3351666087/desktop-tutorial/docs/presentation/SmartClassroom_IoT104TC_Demo.pptx

Smart Classroom

Energy-Saving, Safety
& Asset Monitoring System

Local-first classroom control with real sensors, actuators, MQTT operations, dashboard analytics and AI-assisted commands.

Local safety works even when the network is offline.

IOT104TC PROJECT

UNO Edge Node

Sensors, state machine and actuators

ESP32 Gateway

Wi-Fi, MQTT and dashboard bridge

UART + ACK

9+

hardware signals

5

priority modes

1s

telemetry cadence

432m

recorded evidence

## Slide 2

ASSESSMENT FIT

Built around the marking scheme

The demo connects hardware, software, architecture, security/privacy, operations and a practical classroom use-case.

Smart Classroom IoT104TC

02

Application

Energy, comfort and safety in one classroom service.

Architecture

UNO local control. ESP32 MQTT gateway.

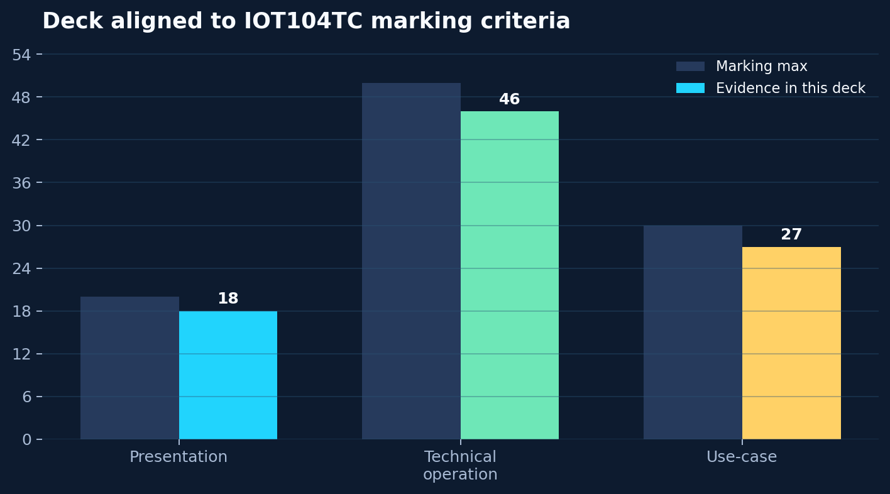
[picture p4: figure]

Evidence

Telemetry, screenshots and self-check.

Security

Fail-safe local control and ignored secrets.

## Slide 3

USE-CASE

A classroom that reacts locally and reports globally

The system behaves like a small building-management service, not a sensor list.

Smart Classroom IoT104TC

03

Sense

Occupancy, light, temperature, gas, flame and emergency button.

01

Decide

Priority state machine: safety first, then comfort and energy saving.

02

Act

Lamp, fan, PWM, tach, buzzer and status light.

03

Operate

MQTT dashboard, manual override, presets, charts and AI timeline.

04

>

>

>

Safety

highest priority

Comfort

adaptive fan/lamp

Ops

ACK + persistence

Data

charts + history

## Slide 4

SYSTEM ARCHITECTURE

Real-time control stays on UNO

Networking adds visibility and commands, but does not become a dependency for safety.

Design decision: ESP32 is a gateway; UNO remains the controller of record.

Smart Classroom IoT104TC

04

Sensors

D2 PIR / A0 Light
A1 Gas / A2 LM35
D8/A3 Flame
D4 Button

Input

Arduino UNO

millis loop
state machine
relay / PWM / tach
buzzer + status light

Edge

ESP32

Serial2 UART
Wi-Fi reconnect
MQTT publish
command bridge

Gateway

Laptop

Mosquitto
web dashboard
history store
AI planner

Service

>

>

>

## Slide 5

Wiring rules

HARDWARE EVIDENCE

Dense hardware, clean responsibility

The build is complex, but each module has a clear role in the service.

Smart Classroom IoT104TC

05

48-kit modules

#18 PIR

#31 TEMT6000

#25 Gas Sensor

#16 Flame Sensor

#5 Active Buzzer

Traffic Light Module

External components

UNO R3
ESP32 Gateway
LM35 powered from ESP32 5V
6-channel relay
12V 4-wire fan
LED + resistor

Common ground is required.
UNO A5 to ESP32 RX2 uses divider.
Relay logic uses RELAY_ON / RELAY_OFF.
No capacitor is added in this build.

ENGINEERING FIX

LM35 became stable after moving power to ESP32 5V and adding ADC guard compensation.

## Slide 6

EDGE INTELLIGENCE

Priority is a state machine

Mixed behavior stays predictable because safety, sensor health, manual control, cooling, lighting and saving are ordered.

Smart Classroom IoT104TC

06

WHY IT MATTERS

Dashboard explains what happened and why.

That turns raw telemetry into an operational classroom service.

SAFETY_ALARM

SENSOR_ERROR

gas/flame/button

invalid sensor state

MANUAL

operator override

COOLING

temperature high

LIGHTING

occupied + dark

ENERGY_SAVING

empty or bright

NORMAL

monitoring

## Slide 7

SAFETY ALARM

The highest-priority path is visible and local

The button gives a safe live demo while gas and flame remain the real sensor paths.

Demo first: press D4, then watch red light, buzzer, fan and dashboard alarm.

Smart Classroom IoT104TC

07

Three inputs

gasDanger
flameDetected
demoEmergency

Trigger

SAFETY ALARM

Overrides lighting, cooling and energy-saving logic immediately.

Decision

Physical response

red light
pulsed buzzer
fan relay ON
PWM = 255

Action

>

>

## Slide 8

Cooling

COMFORT + ENERGY

Human-friendly automation

The classroom avoids waste without making the controls feel abrupt.

Smart Classroom IoT104TC

08

Lighting

Bright room: lamp stays off even if PIR sees motion.
Dark room + occupied: lamp turns on.
No occupancy timeout: lamp turns off.

Temperature threshold starts the relay.
PWM ramps fan intensity.
Tach RPM is interrupt-based and never blocks the system.

10s

occupancy timeout

PWM

smooth fan path

ACK

config confirmed

Local

works offline

## Slide 9

MQTT NETWORK LAYER

Telemetry goes up; commands come back with ACK

The protocol is simple enough to debug and structured enough for a dashboard.

SC2,mode=SAFETY_ALARM,pir=1,temp10=286,gas=520
fan=1,pwm=255,rpm=1320,status=R

ACK loop proves the command actually landed on the UNO.

Smart Classroom IoT104TC

09

Emit

SoftwareSerial line every second

UNO

Parse

Serial2 + Wi-Fi reconnect

ESP32

Publish

JSON plus key topics

MQTT

Operate

Config + presets
manual mode

Web

>

>

>

## Slide 10

DASHBOARD

An operator console, not a raw JSON page

Large cards, live charts, mobile access, manual mode and scene presets make the system usable.

Dashboard screenshots captured from the local running system.

10

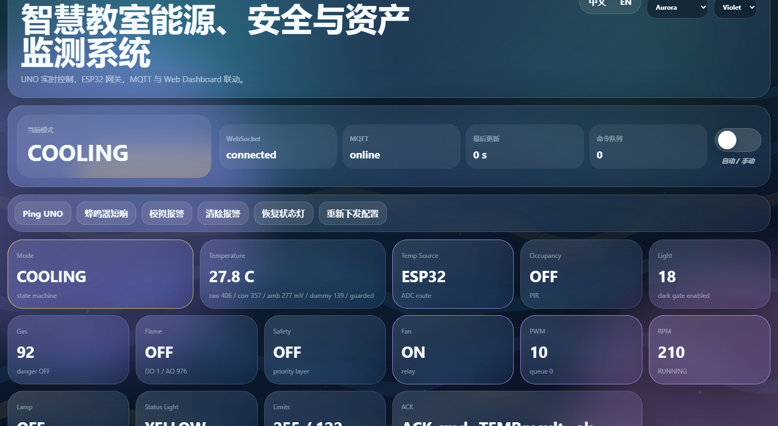
[picture p5: figure]
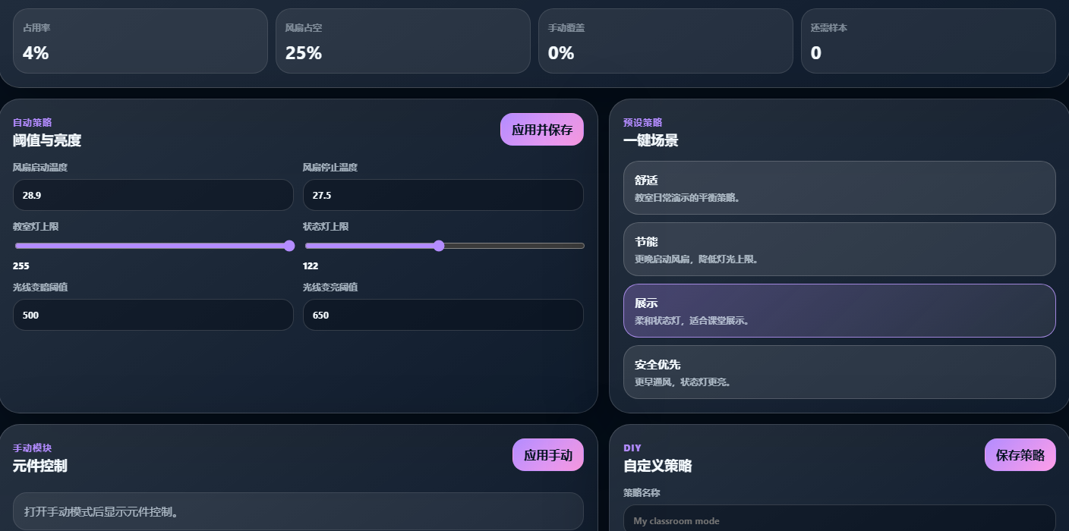
[picture p6: figure]
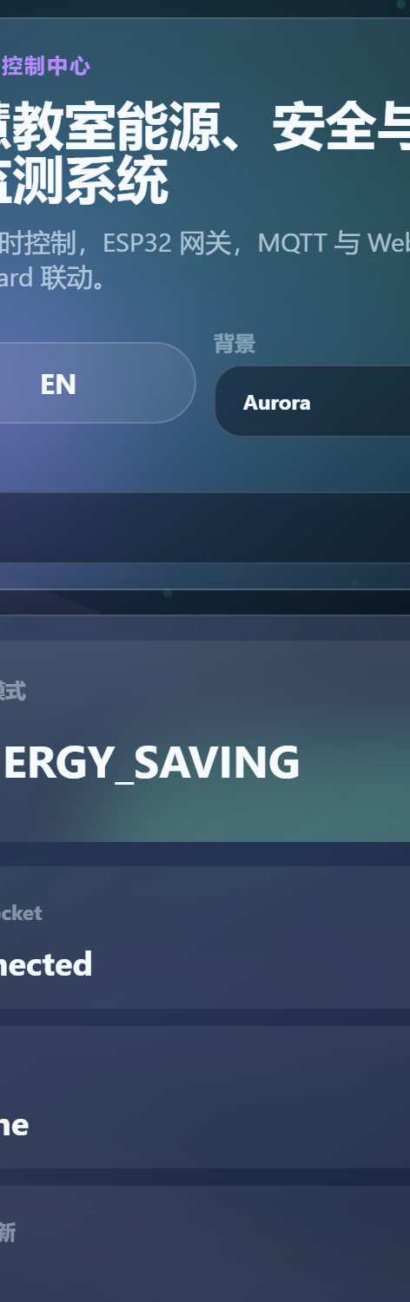
[picture p7: figure]

Auto

manual switch

Scenes

one-click presets

## Slide 11

TELEMETRY EVIDENCE

The demo has history, not just live values

Recorded data supports behavior explanation: modes, temperature response, fan duty and safety events.

9,764 samples | avg temp 28.3C | fan duty 31.5% | safety events 5

Smart Classroom IoT104TC

11

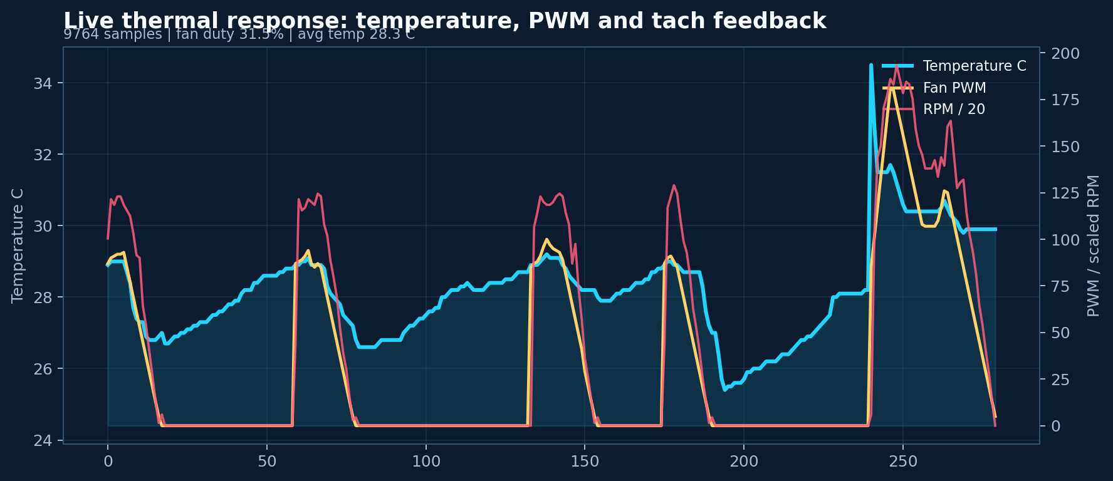
[picture p8: figure]
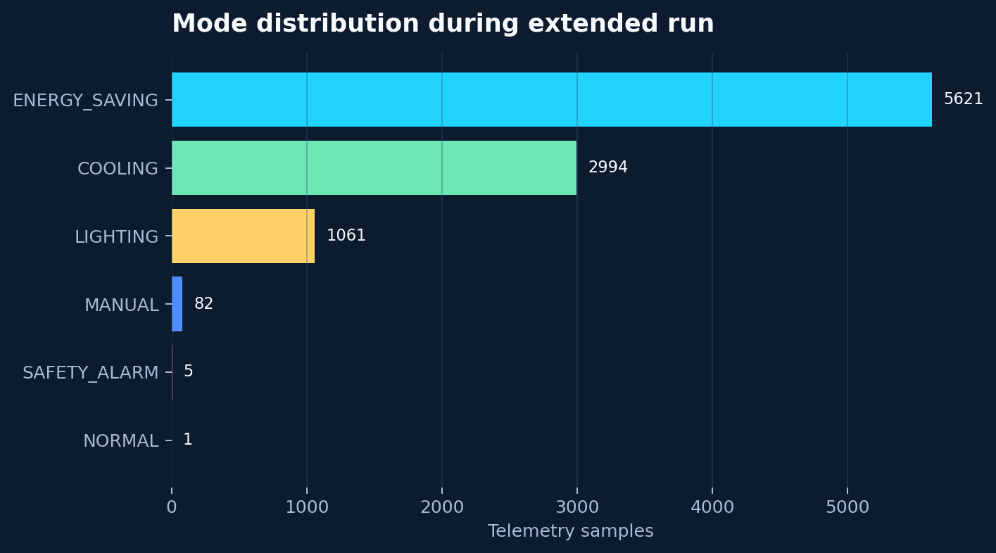
[picture p9: figure]

## Slide 12

MEASURED COMPLEXITY

Complexity comes from closed loops

Sensors, control, gateway, dashboard, persistence and AI all interact with the same physical system.

Smart Classroom IoT104TC

12

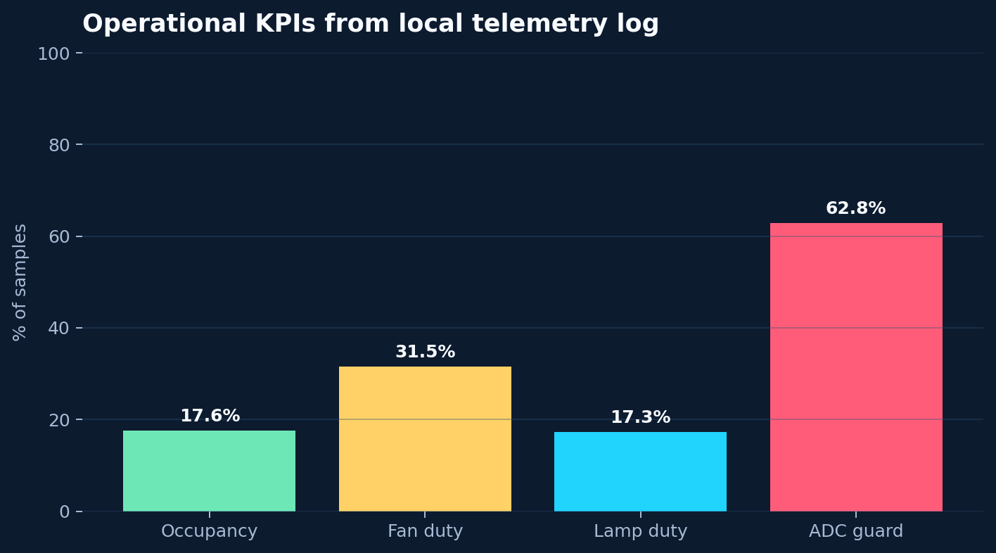
[picture p10: figure]

9,764

telemetry samples

12+

MQTT topics

2-way

UART command + ACK

Local-first

safety path offline

34/34

delivery self-check PASS

## Slide 13

AI OPERATIONS LAYER

Natural language becomes structured control

AI is useful because it turns vague operator intent into ordered tasks and timed actions.

Smart Classroom IoT104TC

13

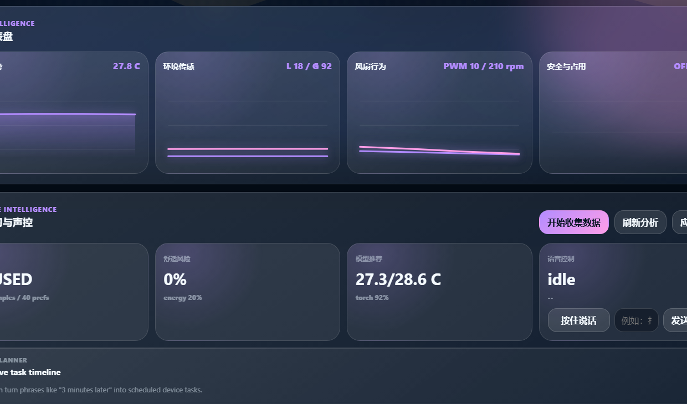
[picture p11: figure]

Voice

Capture

Browser mic input

STT

Text

faster-whisper

Qwen

Plan

structured tasks

>

>

Timeline

Delayed actions auto-clear after completion.

Data

Overrides guide comfort.

## Slide 14

Operations boundary

SECURITY, PRIVACY & OPERATIONS

Demo-friendly, but risk-aware

The project separates safety-critical local control from network convenience and AI assistance.

Production hardening path: authenticated MQTT, TLS, enclosure, fuse, isolation and power filtering.

Smart Classroom IoT104TC

14

Safety boundary

Safety alarm, buzzer, red light and fan response are local on UNO.

Privacy boundary

Microphone is user-triggered and requires browser permission.

MQTT status, ACK logs, persistence and self-check reduce demo risk.

## Slide 15

DEMO CHOREOGRAPHY

Show the strongest engineering first

The audience should see safety and edge control before dashboard polish and AI features.

Do not open with AI. Open with physical safety response.

Smart Classroom IoT104TC

15

Safety

button -> red light -> buzzer -> fan high

P1

Edge

UNO local controller and priority modes

P2

Energy

PIR + light + temp drive lamp and fan

P3

IoT

UART, MQTT topics and ACK command loop

P4

AI

voice, Qwen, timeline and data preference

P5

>

>

>

>

## Slide 16

Self-check gates

REFERENCES + SELF-CHECK

Ready to inspect, rebuild and present

The final package includes sources, assembly materials, scripts and a repeatable delivery check.

Final claim: a local-first IoT classroom controller with safety, energy saving, operations and evidence-backed intelligence.

Smart Classroom IoT104TC final presentation package

16

References

Arduino UNO R3 docs
Espressif Arduino-ESP32 Serial docs
Eclipse Mosquitto config docs
Arduino PubSubClient docs
Texas Instruments LM35 page

PPT structure
required docs
firmware presence
secret scan
Node/Python syntax
UNO + ESP32 compile
