3351666087/desktop-tutorial/docs/SELF_CHECK_REPORT.md

# Smart Classroom Delivery Self-Check

- Generated: 2026-05-27 22:06:02
- Root: `D:\desktop\新项目`
- Summary: PASS 74 / WARN 0 / FAIL 0

| Status | Check | Detail |
| --- | --- | --- |
| PASS | required file: README.md | 12,310 bytes |
| PASS | required file: docs/presentation/SmartClassroom_IoT104TC_Demo.pptx | 2,267,528 bytes |
| PASS | required file: docs/presentation/SmartClassroom_IoT104TC_Demo.pdf | 790,604 bytes |
| PASS | required file: docs/FOUR_PERSON_PRESENTATION_PLAN_ZH.md | 9,574 bytes |
| PASS | required file: docs/SmartClassroom_4Person_Presentation_Plan_ZH.pdf | 335,820 bytes |
| PASS | required file: docs/SmartClassroom_Team_Guide_ZH.pdf | 485,673 bytes |
| PASS | required file: dist/SmartClassroom_Team_Delivery_Pack.zip | 3,857,106 bytes |
| PASS | required file: docs/SmartClassroom_Port_Connection_Check_ZH.pdf | 298,305 bytes |
| PASS | required file: docs/SmartClassroom_Feature_Logic_Guide_ZH.pdf | 451,359 bytes |
| PASS | required file: docs/TEAM_FEATURE_GUIDE_ZH.md | 14,121 bytes |
| PASS | required file: docs/SmartClassroom_Assembly_Checklist_ZH.pdf | 298,305 bytes |
| PASS | required file: docs/SmartClassroom_Environment_Setup_ZH.pdf | 303,858 bytes |
| PASS | required file: docs/SmartClassroom_Speech_Script_Bilingual.pdf | 275,491 bytes |
| PASS | required file: docs/SmartClassroom_Onsite_Assembly_Checklist.pdf | 680,525 bytes |
| PASS | required file: docs/ASSEMBLY_CHECKLIST.md | 6,845 bytes |
| PASS | required file: docs/ENV_SETUP_ZH.md | 6,601 bytes |
| PASS | required file: docs/TEAM_FLOWCHART_ZH.md | 4,050 bytes |
| PASS | required file: docs/SmartClassroom_Team_Flowchart_ZH.png | 267,837 bytes |
| PASS | required file: docs/SPEECH_SCRIPT_BILINGUAL.md | 12,003 bytes |
| PASS | required file: docs/CW2_Cover_Sheet_EN.md | 1,754 bytes |
| PASS | required file: docs/CW2_Final_Project_Report_EN.md | 16,270 bytes |
| PASS | required file: docs/CW2_Marking_Criteria_Response_EN.md | 5,195 bytes |
| PASS | required file: docs/CW2_GitHub_Runbook_EN.md | 3,852 bytes |
| PASS | required file: docs/submission/00_Cover_Sheet.pdf | 76,694 bytes |
| PASS | required file: docs/submission/01_Final_Project_Report.pdf | 1,582,464 bytes |
| PASS | required file: docs/submission/02_Marking_Criteria_Response.pdf | 84,440 bytes |
| PASS | required file: docs/submission/03_GitHub_Runbook.pdf | 105,808 bytes |
| PASS | required file: docs/lmc_submission/01_Project_Description_Report.pdf | 1,582,464 bytes |
| PASS | required file: docs/lmc_submission/02_Demonstration_Slides.pdf | 790,604 bytes |
| PASS | required file: docs/lmc_submission/03_GitHub_Repository_And_Runbook.pdf | 105,808 bytes |
| PASS | required file: docs/lmc_submission/04_Hardware_Port_Connection_Check.pdf | 146,680 bytes |
| PASS | required file: docs/lmc_submission/05_Feature_Logic_Guide.pdf | 153,071 bytes |
| PASS | required file: dist/SmartClassroom_LMC_PDF_Submission_Pack.zip | 2,200,677 bytes |
| PASS | required file: dist/SmartClassroom_CW2_Final_Submission_Pack.zip | 4,971,997 bytes |
| PASS | required file: UNO_Phase3_TelemetryPatch/UNO_Phase3_TelemetryPatch.ino | 35,474 bytes |
| PASS | required file: ESP32_3B_MQTT_Gateway/ESP32_3B_MQTT_Gateway.ino | 27,318 bytes |
| PASS | required file: SmartClassroom_WebDashboard/server.js | 60,857 bytes |
| PASS | required file: SmartClassroom_WebDashboard/public/app.js | 48,427 bytes |
| PASS | required file: SmartClassroom_WebDashboard/public/styles.css | 23,507 bytes |
| PASS | required file: run_smartclassroom.py | 2,097 bytes |
| PASS | required file: smartclassroom_launcher.py | 8,255 bytes |
| PASS | pptx slide count | 16 slides |
| PASS | pptx embedded media | 8 media files |
| PASS | pptx minimum font size | 16.5 pt |
| PASS | ppt keyword: SAFETY_ALARM | present |
| PASS | ppt keyword: Arduino UNO | present |
| PASS | ppt keyword: ESP32 | present |
| PASS | ppt keyword: MQTT | present |
| PASS | ppt keyword: Dashboard | present |
| PASS | ppt keyword: Qwen | present |
| PASS | ppt keyword: ACK | present |
| PASS | ppt keyword: References | present |
| PASS | ppt keyword: self-check | present |
| PASS | ppt layout QA: slide bounds | 16 slides checked |
| PASS | ppt layout QA: text overflow | no estimated text overflow |
| PASS | ppt layout QA: container fit | text boxes stay inside detected containers |
| PASS | ppt layout QA: arrowheads | no unrotated triangle arrowheads detected |
| PASS | ppt layout QA: container overlaps | no non-nested container collisions detected |
| PASS | ppt visual QA: PowerPoint render | 16/16 slides rendered |
| PASS | ppt visual QA: ink vs text box | 268 text elements checked |
| PASS | ppt visual QA: ink vs container | rendered text ink stays inside detected containers |
| PASS | sensitive key scan | no obvious API keys in tracked delivery files |
| PASS | node syntax: SmartClassroom_WebDashboard/server.js | ok |
| PASS | node syntax: SmartClassroom_WebDashboard/public/app.js | ok |
| PASS | python syntax: run_smartclassroom.py | ok |
| PASS | python syntax: smartclassroom_launcher.py | ok |
| PASS | python syntax: tools/generate_team_flowchart.py | ok |
| PASS | python syntax: tools/build_team_pdfs.py | ok |
| PASS | python syntax: tools/build_cw2_submission_pack.py | ok |
| PASS | python syntax: tools/build_lmc_submission_pdfs.py | ok |
| PASS | python syntax: tools/check_ai_backend_runtime.py | ok |
| PASS | python syntax: smart_ai/ai_backend_service.py | ok |
| PASS | arduino compile: UNO_Phase3_TelemetryPatch | Sketch uses 17004 bytes (52%) of program storage space. Maximum is 32256 bytes.<br>Global variables use 1089 bytes (53%) of dynamic memory, leaving 959 bytes for local variables. Maximum is 2048 bytes. |
| PASS | arduino compile: ESP32_3B_MQTT_Gateway | Sketch uses 757949 bytes (57%) of program storage space. Maximum is 1310720 bytes.<br>Global variables use 45568 bytes (13%) of dynamic memory, leaving 282112 bytes for local variables. Maximum is 327680 bytes. |
