3351666087/desktop-tutorial/docs/CW2_Cover_Sheet_EN.md

# XJTLU Entrepreneur College (Taicang) Cover Sheet

## Module And Assignment

| Field | Content |
|---|---|
| Module code and title | IOT104TC: Introduction to IoT |
| School title | School of Internet of Things |
| Assignment title | Final Project: Group Work Lab Demonstrations |
| Project title | Smart Classroom Energy-Saving, Safety & Asset Monitoring System |
| Submission deadline | 27 May 2026, China Time, GMT+8 |
| GitHub repository | https://github.com/3351666087/desktop-tutorial |
| Anonymous teaching and learning use | Yes |

## Group Members

| Student | Student ID |
|---|---:|
| Rui Huang | 2471007 |
| Jingzhe Zhang | 2472494 |
| Tianyu Bai | 2471763 |
| Chenyun Xu | 2470797 |

## Academic Integrity Declaration

By submitting this coursework package, we certify that we have read and understood the University policy for dealing with plagiarism, collusion and fabrication of data. To the best of our knowledge and belief:

- The submitted work does not contain plagiarism or collusion.
- The submitted work does not contain fabricated data.
- The GitHub repository, firmware, dashboard, AI backend, documents and demo materials represent the project implementation produced by the group.

## Submission Contents

| Item | File |
|---|---|
| Final project report | `01_Final_Project_Report.pdf` |
| Marking criteria response | `02_Marking_Criteria_Response.pdf` |
| GitHub and runbook evidence | `03_GitHub_Runbook.pdf` |
| Demonstration slide deck | `04_Demo_PPTX.pptx` |
| Demonstration slide deck PDF | `05_Demo_PPT_PDF.pdf` |
| Wiring and onsite assembly checklist | `06_Port_Connection_Check_ZH.pdf` |
| Detailed feature logic guide | `07_Feature_Logic_Guide_ZH.pdf` |
| Automated self-check report | `08_Self_Check_Report.md` |
