3351666087/desktop-tutorial/docs/presentation/assets/dashboard_desktop.png

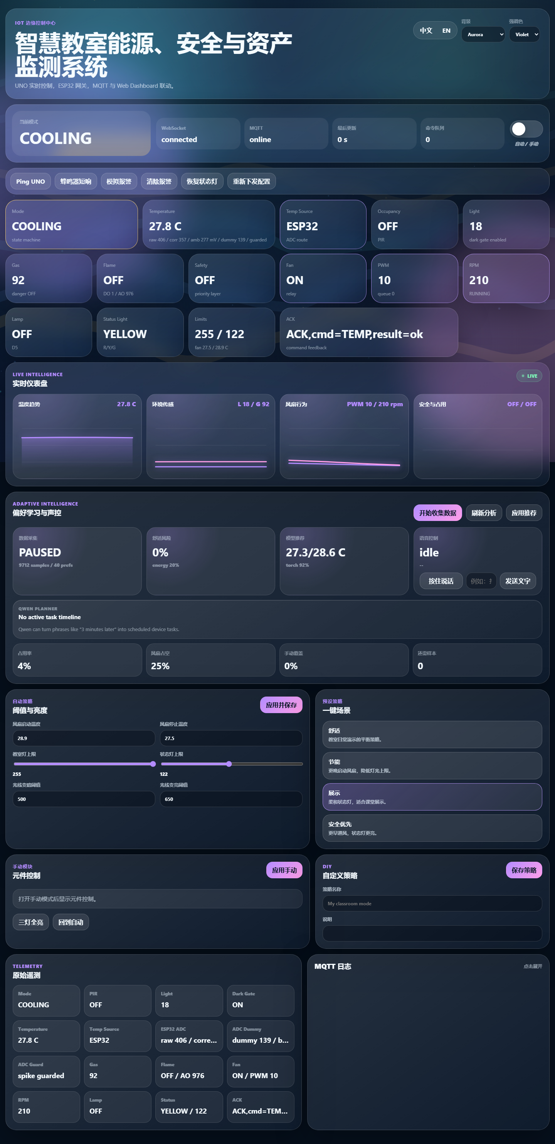
docs/presentation/assets/dashboard_desktop.png
