3351666087/desktop-tutorial/docs/presentation/assets/dashboard_intelligence.png

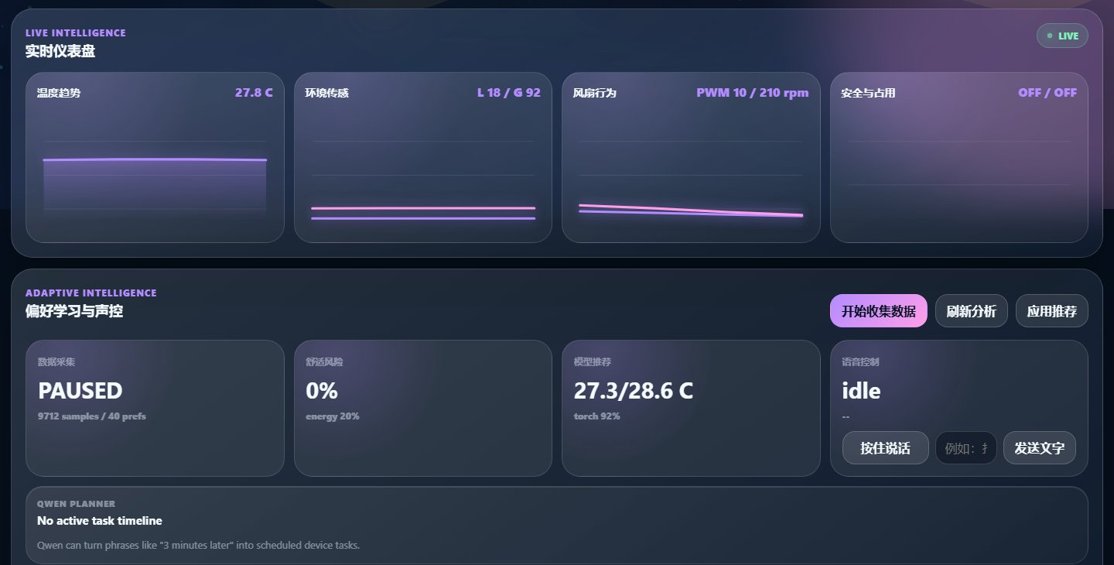
docs/presentation/assets/dashboard_intelligence.png
