3351666087/desktop-tutorial/docs/presentation/assets/dashboard_mobile.png

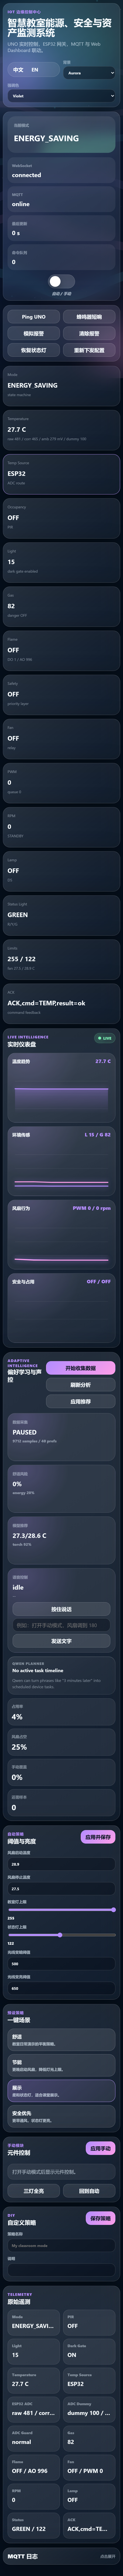
docs/presentation/assets/dashboard_mobile.png
