3351666087/desktop-tutorial/docs/SmartClassroom_Onsite_Assembly_Checklist.pdf

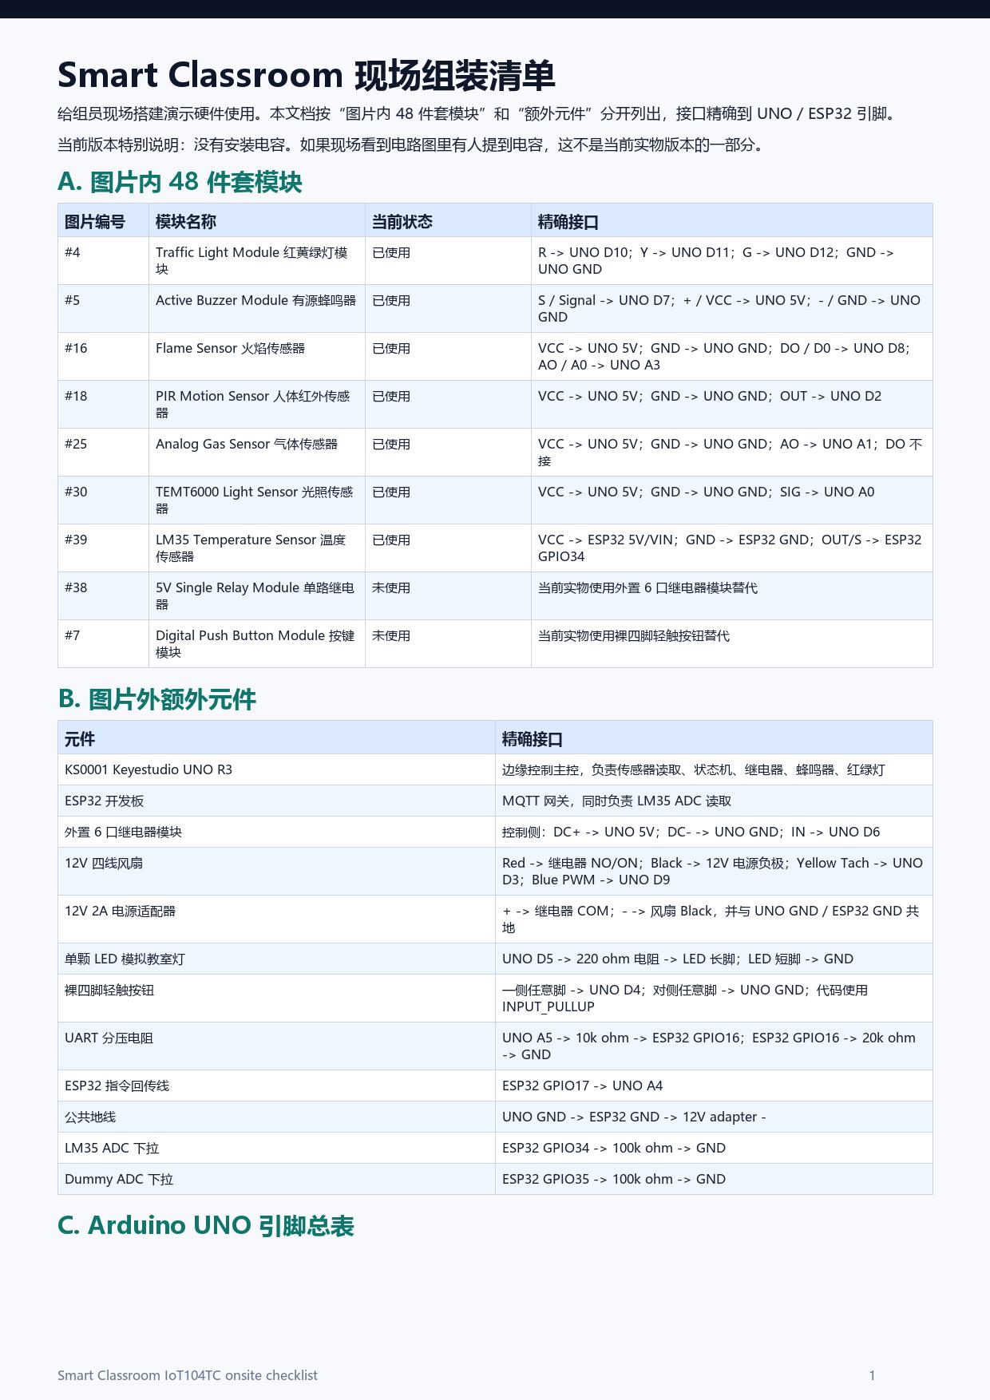
[picture p41: page 1]
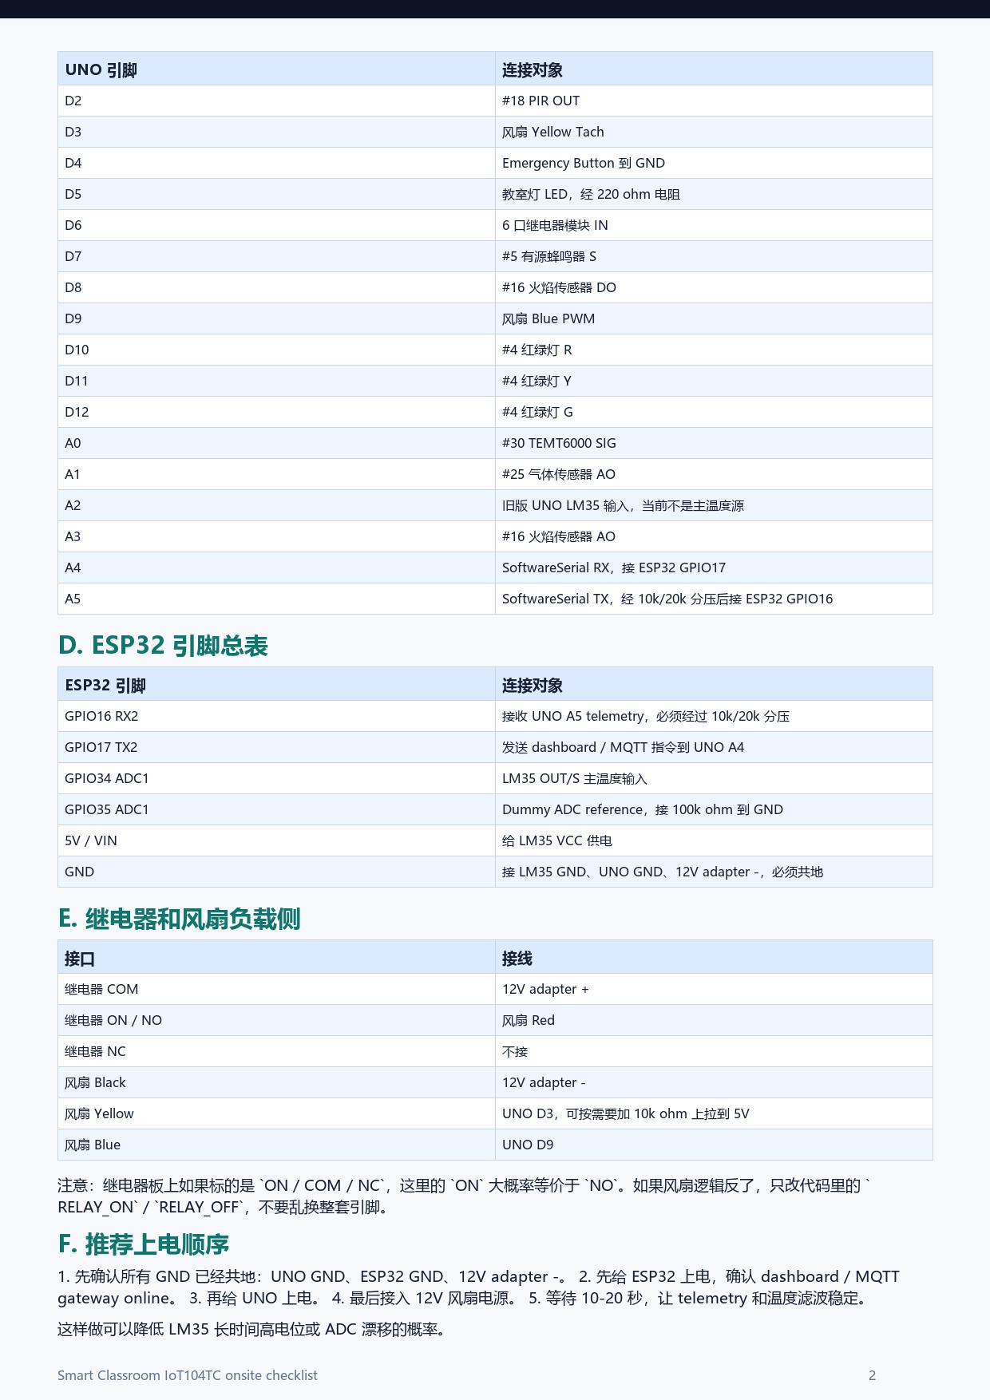
[picture p42: page 2]
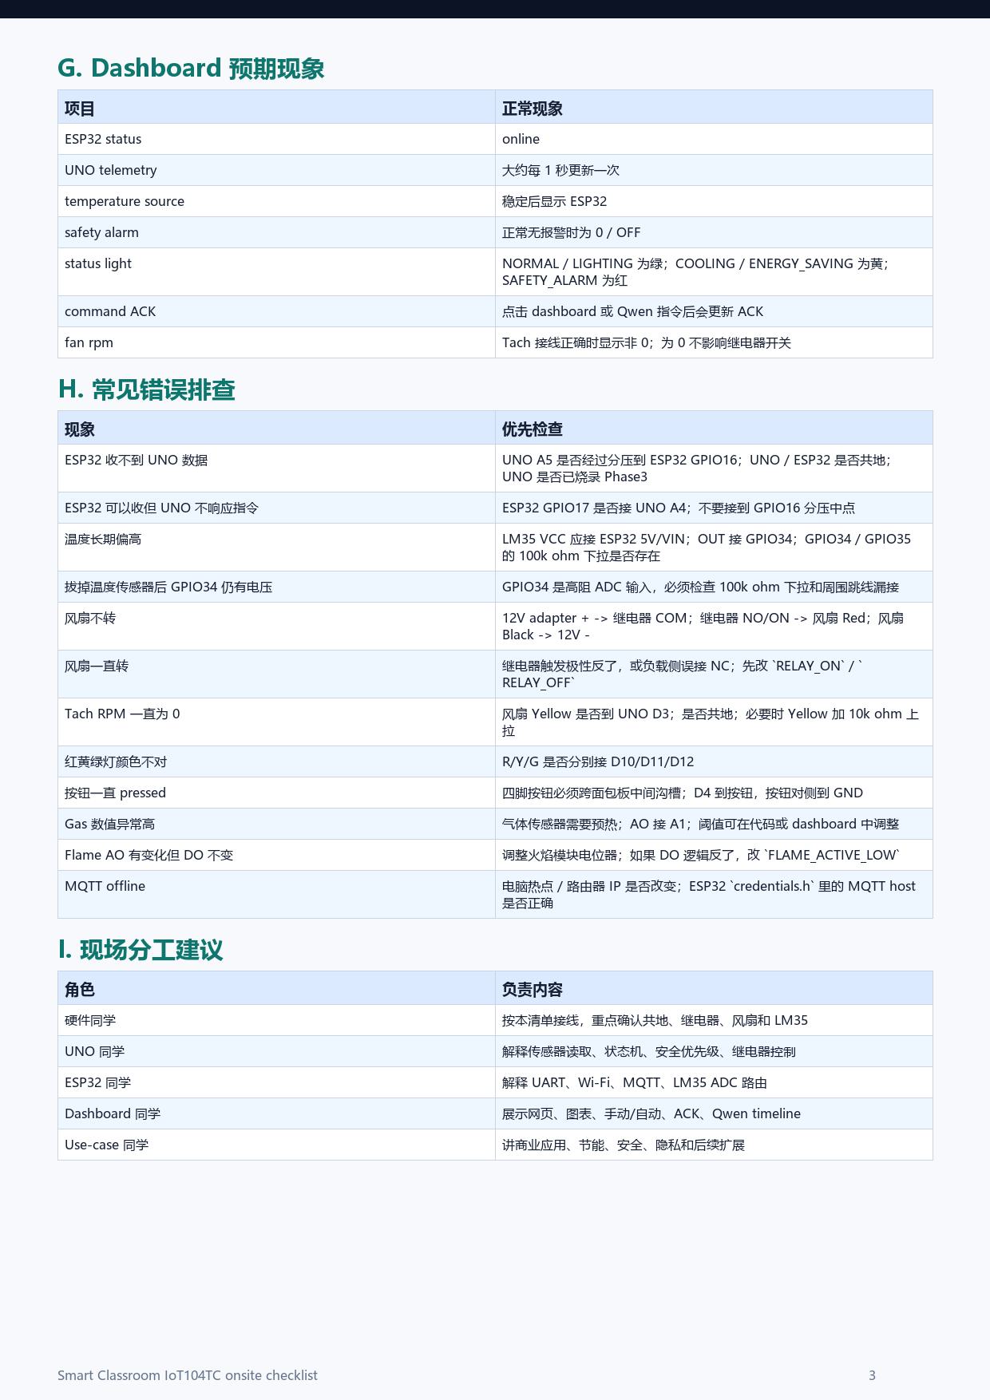
[picture p43: page 3]
