3351666087/desktop-tutorial/ESP32_3B_MQTT_Gateway/credentials.example.h

#pragma once

// Copy this file to credentials.h and edit values for the demo laptop/network.
// credentials.h is intentionally ignored by Git.

#define SMARTCLASSROOM_WIFI_SSID "SmartClassroom-IoT"
#define SMARTCLASSROOM_WIFI_PASSWORD "12345678"
#define SMARTCLASSROOM_MQTT_HOST "192.168.137.1"

// Optional fallback profile, useful when using a phone/router instead of Windows hotspot.
#define SMARTCLASSROOM_FALLBACK_WIFI_SSID ""
#define SMARTCLASSROOM_FALLBACK_WIFI_PASSWORD ""
#define SMARTCLASSROOM_FALLBACK_MQTT_HOST "192.168.137.1"
