3351666087/desktop-tutorial/(commit log)

2026-05-18 Polish presentation and translate assembly checklist
2026-05-24 Upgrade presentation and team briefing materials
2026-05-24 Add PowerPoint visual ink QA
